wozlol/arduinoboy-RP2040-USB_MIDI_Host/README.md

# Arduinoboy RP2040 HOST EDITION by woz.lol

## Update the firmware
The latest ready-to-flash firmware is in the [Firmware](Firmware) folder. You do not need to compile anything.
1. Download [Arduinoboy-Host-Edition.uf2](Firmware/Arduinoboy-Host-Edition.uf2) (on GitHub, open the file and click the download button).
2. Short the FIRMWARE pads on the board and plug in USB-C to your computer. (you can unshort the pads a second after you plug it in)
3. A drive appears on your computer named `RPI-RP2`. Drag the `.uf2` file onto it.
4. The board restarts by itself and the lights run in order. The update is done.

The [Firmware README](Firmware/README.txt) says which source commit the file was built from and what has been tested.

Based on the ArduinoBoy Repository for serial MIDI communication to the Nintendo Gameboy.

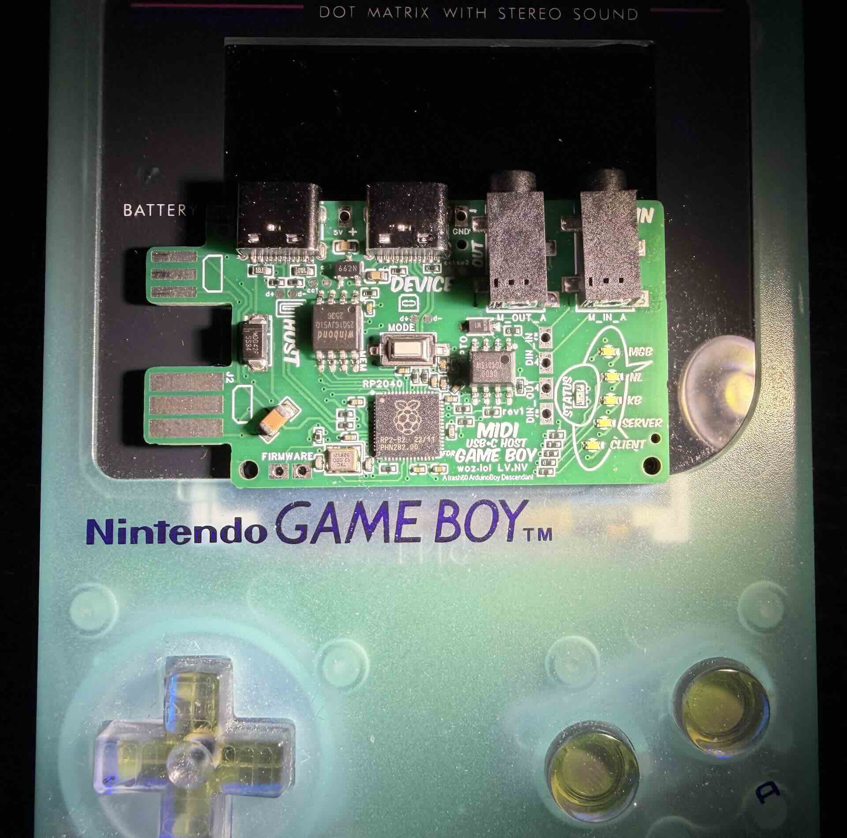
[picture p1: ArduinoBoy_USB_HOST_and_Power_MIDI_Keyboard_from_Gameboy_woz.lol.jpeg]


## About 
Arduinoboy is software for the [Arduino hardware platform](http://arduino.cc) that allows serial communication (MIDI) to the Nintendo Gameboy for music applications such as [LittleSoundDJ](http://littlesounddj.com), [Nanoloop.](http://www.nanoloop.com/), and [mGB](https://github.com/trash80/mGB)

## RP2040 USB MIDI Host Additions
This fork adds RP2040 / Arduino-Pico support focused on USB MIDI host use: a PIO-USB host port for class-compliant USB MIDI keyboards and controllers, plus built-in USB MIDI device support for the Max editor and computer MIDI connections. It has been tested on the Waveshare RP2040 Zero.

The RP2040 built-in USB port enumerates as a USB MIDI device named `Game Boy`. The GPIO14/GPIO15 port works as a USB MIDI host.

## Schematic
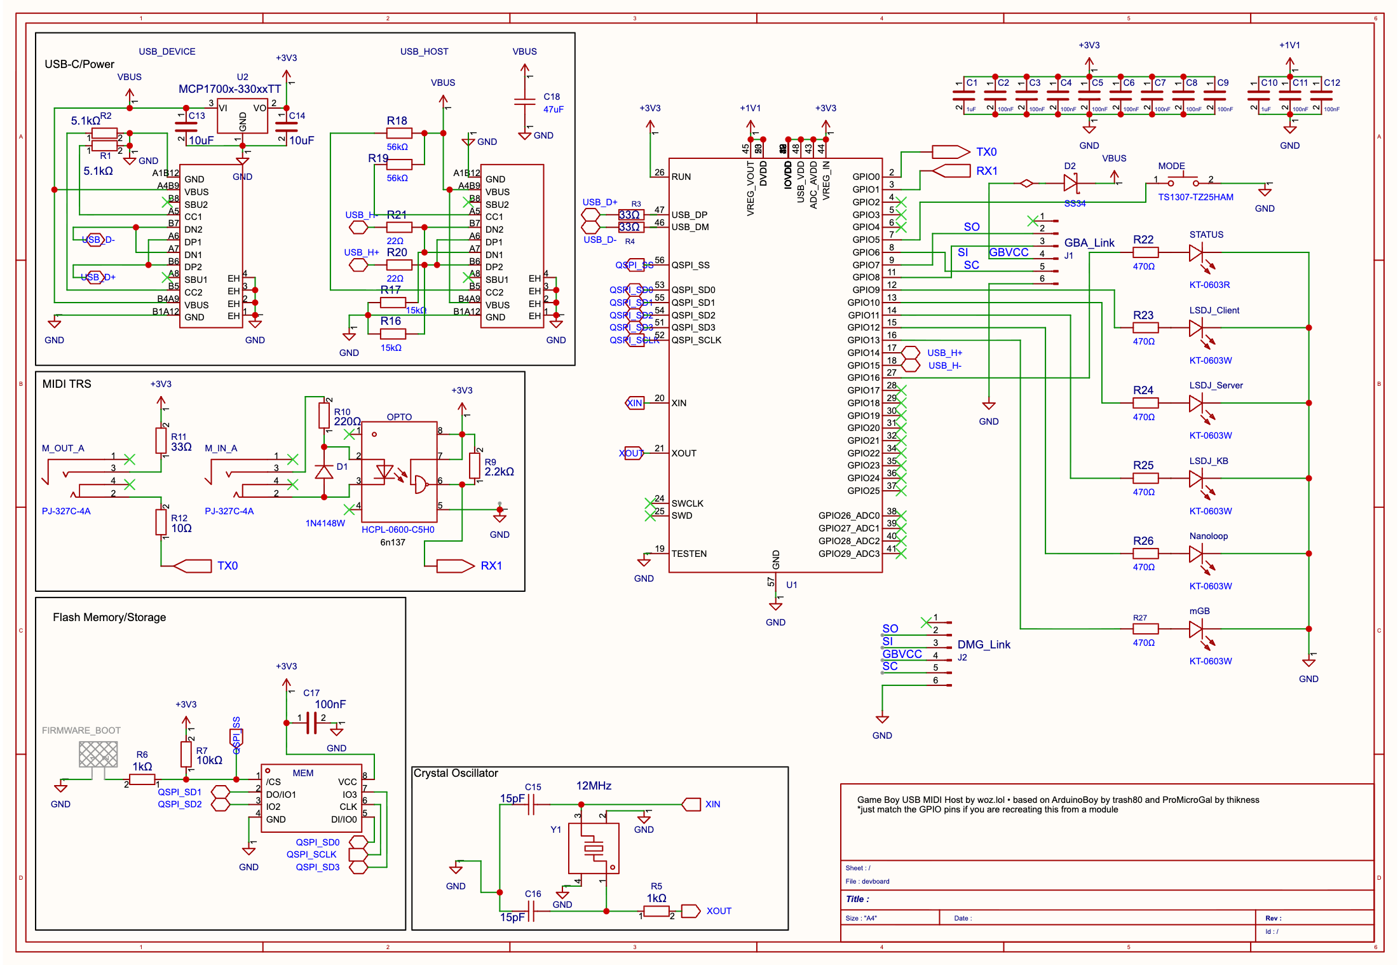
[picture p2: Schematic/SCH_GBHOST_1-GBHOST_2026-07-27.png]
GBHOST schematic


[Download the schematic PDF](Schematic/SCH_GBHOST_2026-07-27.pdf)

<p>
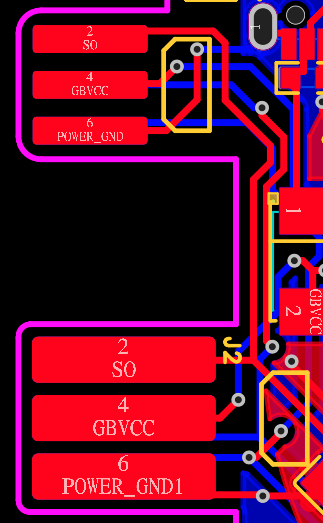
[picture p3: Schematic/game boy jacks front.png]
Game Boy jack front
  
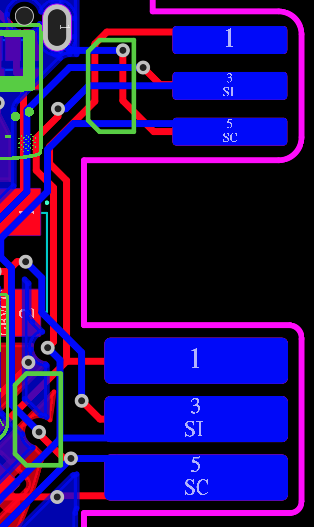
[picture p4: Schematic/game boy jacks back.png]
Game Boy jack back
  
</p>

### RP2040 / Arduino-Pico Pin Settings
* 6 LEDs on GPIO pins 9, 10, 11, 12, 13, 16
* Push button on GPIO pin 5
* Gameboy Clock line on GPIO pin 6
* Gameboy Serial Data input on GPIO pin 7
* Serial Data from gameboy on GPIO pin 8
* USB MIDI host D+ through a 22 ohm resistor to GPIO pin 14
* USB MIDI host D- through a 22 ohm resistor to GPIO pin 15
* USB MIDI host port requires 5V VBUS power, and two 15k resistors: one from D+ to ground, and one from D- to ground.

### RP2040 USB Host Notes
* Set CPU Speed to `240 MHz (Overclock)` for maximum MIDI controller compatibility.
* Use a ground wire to the USB host thicker than 30 AWG.
* Twist D+ and D-, and keep them short.
* Put the 22 ohm resistors near the RP2040.

### Building the firmware
Don't want to build it? Use the ready-made file in the `Firmware` folder and follow the `README.txt` next to it.

To build it yourself in the Arduino IDE:
1. In Boards Manager install "Raspberry Pi Pico/RP2040" by Earle F. Philhower, III, version 5.6.1. In Library Manager install "MIDI Library", version 5.0.2.
2. One-time step: copy the two folders `Adafruit_TinyUSB_Library` and `Pico_PIO_USB` from `Arduinoboy/libraries` into your `Documents/Arduino/libraries` folder, and say yes to replace. Arduino does not look in the repo folder by itself. This swaps in our edited copies for all your projects, and our USB library turns off USB host support for keyboards, storage and serial. If you use those elsewhere, move your original folders somewhere outside `libraries` first.
   On a Mac you can double-click `Install-Libraries-Mac.command` in the repository folder instead. It shows what it will do and asks first, and it moves your own copies to `Documents/Arduino_library_backups` before copying ours in. If macOS refuses to open it, right-click the file and choose Open. On Windows and Linux, copy the folders by hand.
3. Open `Arduinoboy/Arduinoboy.ino`, the file inside the inner `Arduinoboy` folder.
4. Choose Tools > Board: Waveshare RP2040 Zero, CPU Speed: 240 MHz, USB Stack: Adafruit TinyUSB. Press Upload.

If the build stops with "ONE-TIME SETUP NEEDED", step 2 was skipped.

From the command line instead, run this in the repository folder. It uses the repo copies for that one build and changes nothing you have installed: `arduino-cli compile --fqbn rp2040:rp2040:waveshare_rp2040_zero:freq=240,usbstack=tinyusb --library Arduinoboy/libraries/Adafruit_TinyUSB_Library --library Arduinoboy/libraries/Pico_PIO_USB --output-dir Arduinoboy/build Arduinoboy`. The firmware is `Arduinoboy/build/Arduinoboy.ino.uf2`.

## Current Features
* Affordable and easily accessible parts for assembly.
* Accurate MIDI Sync, Start and Stop commands.
* Push Button selector sets the sync/state modes [(7 modes available)](#modes-details)
* [mGB](https://github.com/trash80/mGB)
 Mode: Full MIDI in support across all 4 Gameboy Channels, including a 3-voice polyphony channel which allows you to play your Game Boy like a synthesizer. 
* Midi Out Doubles as a Midi Thru
* "Filtering" data for only sync messages, no dedicated MIDI line required.
* Can be powered by the Game Boy's gamelink port.
* USB upgradeable via Arduino. Short firmware pins for firmware update.
* Midi settings configurable using the new no-install web editor at https://woz.lol/arduinoboy/ or the old Mac/PC editor built in Max.
* Tested and works with DMG (Original), Gameboy Color, and Advance/SP. mGB will not work on an Advance with an Advance cart, an Advance must use a Gameboy cart.

## Modes Details
#### Mode 1 - LSDJ as MIDI Slave Sync
Slave your Game Boy running [LittleSoundDJ](http://littlesounddj.com) to your midi sequencer or Digital audio workstation.  

You can send the arduinoboy midi notes to change sync resolution and start/stop the LSDJ sequencer.  

_LSDJ Slave Mode Midi Note Effects:_

* 48 - `C-2` Sends a Sequencer Start Command
* 49 - `C#2` Sends a Sequencer Stop Command
* 50 - `D-2` Toggles Normal Tempo 
* 51 - `D#2` Toggles 1/2 Tempo
* 52 - `E-2` Toggles 1/4 Tempo
* 53 - `F-2` Toggles 1/8 Tempo

Higher note values than these map LSDJ song position row offset on a Song Start.

In LSDJ the `sync` mode should be set to `MIDI` (`Slave` in older LSDJ versions)
 
#### Mode 2 LSDJ as MIDI Master Sync. 

Send Midi sync with LSDJ as a midi clock master, LSDJ also sends a Midi Note on message that corresponds to the song row number on play.

In LSDJ the `sync` mode should be set to `LSDJ` (`Master` in older LSDJ versions)

#### Mode 3 LSDJ PC Keyboard mode.
This mode emulates the [PC Keyboard Mode](http://littlesounddj.wikia.com/wiki/PC_Keyboard_Interface) built into LSDJ, allowing you to control the following aspects of LSDJ: 

Features:

* The first octave controls M-U-T-E, 
* Cursor control (LSDJ Live mode only), 
* Table selection
* Table cue.

_PC Keyboard mode midi note map_

* 36 - `C-1` Mute Pu1 Off/On
* 37 - `C#1` Mute Pu2 Off/On
* 38 - `D-1` Mute Wav Off/On
* 39 - `D#1` Mute Noi Off/On
* 40 - `E-1` Livemode Cue Sequence
* 41 - `F-1` Livemode Cursor Up
* 42 - `F#1` Livemode Cursor Down
* 43 - `G-1` Livemode Cursor Left
* 44 - `G#1` Live mode Cursor Right
* 45 - `A-1` Table Up
* 46 - `A#1` Table Down
* 47 - `B-1` Cue Table
* 48+ - Notes from this note up will accept midi in from an external keyboard or sequencer and allow you to play the notes`C-2 to C-8`.  
* Midi Program Change messages will select from instrument table
* Default Midi channel is 16. You can set this in the top of the main source file in the archive, or via the [Max Pat editor](#max).

In LSDJ the `sync` mode should be set to `KEYBD` (`Keyboard` in older LSDJ versions)

#### Mode 4 MIDI to Nanoloop sync
Sync [Nanoloop.](http://www.nanoloop.com/) to external midi clock signals sent to the midi in.

In Nanoloop, the sync mode should be set to `slave`.

#### Mode 5 Full MIDI with mGB
[mGB](https://github.com/trash80/mGB) is a Gameboy cartridge program (You need a Flash Cart and Transfer hardware) That enables the Gameboy to act as a MIDI supported sound module that allows full control of the Game Boy sound hardware.

It works with the old DMG Gameboy as well as GBC/GBA. Game Boy Advance must use a non-Advance Game Boy cart.

On the RP2040 build, mGB mode also provides a three-way MIDI thru. MIDI received
from the serial MIDI port, built-in USB MIDI device port, or USB MIDI host port
is sent to the Game Boy as before and mirrored to all three MIDI outputs. This
allows the Arduinoboy to work as a USB MIDI adapter while it is in mGB mode.

#### Mode 6 LSDJ MIDIMAP 
Lsdj will sync to incoming MIDI sync, and incoming MIDI notes are mapped to LSDJ's song row #. The currently selected row's MIDI note is displayed on the top right of the LSDJ screen, and incoming MIDI notes will also display the relative song row number in the same location.

In LSDJ the `sync` mode should be set to `MI.MAP`. 

*This requires a special version of LSDJ, which can be found in your account on the [LSDJ website](http://littlesounddj.com/lsd/latest/full_version/).*

#### Mode 7 LSDJ MIDIOUT
Each of the 4 gameboy channels send MIDI data on 4 midi channels by the use of effects commands:

* `Nxx` - Sends a MIDI Note - Absolute to the value placed in the effect. N00 sends note off, `N01`-`N6F` send midi notes 1 to 112.
* `Qxx` - Sends a [MIDI Note](http://www.electronics.dit.ie/staff/tscarff/Music_technology/midi/midi_note_numbers_for_octaves.htm) relative to the current channel's pitch. The effect value is a offset. so `Q0C` in `PU1` would send a note 1 octave higher than what `PU1` is currently playing. This is useful as a table command to track midi notes as normal notes in the sequencer.
* `Xxx` - Sends a MIDI CC - By default in Arduinoboy the high nibble selects a CC#, and the low nibble sends a value `0-F` to `0-127`. This can be changed to allow just 1 midi CC with a range of `00`-`6F`, or 7 CCs with scaled or unscaled values.
* `Yxx` - Sends a program/patch/preset change.

By default each channel of LSDJ is mapped to midi channels 1-4. For example note commands from PU1 will be sent to midi channel 1. 

In LSDJ the `sync` mode should be set to `Midiout`. 

*This requires a special version of LSDJ, which can be found in your account on the [LSDJ website](http://littlesounddj.com/lsd/latest/full_version/).*

## New Web Editor
Editor gui
[The No-Install Web Editor for Arduinoboy](https://woz.lol/arduinoboy/)
Allows you to edit the various global midi settings of your arduinoboy without editing or flashing code, over midi, from your Chrome browser.

## Max Editor
[The Arduinoboy Editor for Max](https://github.com/trash80/Arduinoboy/tree/master/Editor) for PC/OSX machines is a gui editor that allows you to edit the various global midi settings of your arduinoboy without editing or flashing code, over midi. It used to required the now deprecated Max Runtime, but you can also run it using a demo of [Cycling '74's Max application](https://cycling74.com/downloads/)

### Maxpat Settings
* `Midi In/Out`
Connect your arduinoboy to these ports on your system. Once it has connected, all the lights on your arduinoboy should flash in order, and the editor will show a green `Connected`.
* `Mode` 
Setting this will tell your arduinoboy what mode to boot into automatically. This is handy if you built your own arduinoboy and decided you wanted to skimp out on LEDs and a button.
* `LSDJ Slave Mode settings` - The midi channel LSDJ slave mode will receive its commands on.
* `LSDJ Master Mode settings` - The midi channel LSDJ Master mode will send its midi notes mapped to row number on.
* `Keyboard Mode settings` - What channel LSDJ will look for its keyboard mode midi commands. No idea what compatibility mode does.
* `mGB midi settings` - Map each incoming midi channel to a specific Gameboy channel in mGB.
* `LSDJ Livesync/Livemap settings` - The midi channel Livesync/Livemap will listen to incoming midi commands from.
* `LSDJ Midiout settings` - Here you can set the following:
	* `Note midi channel` -  The channel each LSDJ channel will send it's midi note commands on.
	* `CC midi channel` -  The channel each LSDJ channel will send it's Continuous Controller commands on.
	* `CC 0` - The initial CC each channel will send. The type of data it will send is based on the next setting.
	* `CC Mode` - Game Boys have limitations! You can either have arduinoboy send one CC with many values, or 7 with limited 8bit values. By default in Arduinoboy the high nibble selects a CC#, and the low nibble sends a value [0-F] to [0-127]. This can be changed to allow just 1 midi CC with a range of 00-6F, or 7 CCs with scaled or unscaled values.
	* `CC Scaling ` - Set wether the 7 CCs are scaled or unscaled.

* [Build Photos](http://flickr.com/photos/trash80/2316803175/in/set-72157604068871573/)
* [Old version (Pre 1.1.0)](http://trash80.net/junkfood/arduinoboy/arduinoboy-schem-v.0.9.8-r1.png)

### Video Demos

  * [Keyboard Mode Test](http://youtube.com/watch?v=TnLUuvc78XY)
  * [Sync Demos](http://youtube.com/watch?v=iVmhy-Lo7BI)
  * [Arduino inside of Gameboy DMG](http://youtube.com/watch?v=VwrMuOA0VnY)
  * [mGB Example & Arduinoboy build into a DMG](http://vimeo.com/1853931)
  * [PDF explores mGB with a MIDI guitar](http://www.youtube.com/watch?v=HAU9MzZ2qeE)

## Thanks To
  * [Arduino](http://arduino.cc)
  * [Nitro2k01](http://blog.gg8.se/wordpress/) for ASM help with mGB 
  * [GWEM](http://www.preromanbritain.com/gwem/lsdj_midi/g33k.html) g33k page
  * [Midines](http://wayfar.net) Thanks for the help x|k!
  * [firestARTer](http://www.firestarter-music.de) help with keyboard & Midi handling information. 
  * [Gijs Gieskes](http://gieskes.nl) Found source code that gave insight into Nanoloop sync
  * [Little Sound DJ](http://littlesounddj.com)
  * [http://devrs.com/gb](http://devrs.com/gb) Madcatz PC link port for gb serial specs
  * [http://chipmusic.org](http://chipmusic.org) For all things Chipmusic.
