wozlol/arduinoboy-RP2040-USB_MIDI_Host/Schematic/SCH_GBHOST_2026-07-27.pdf

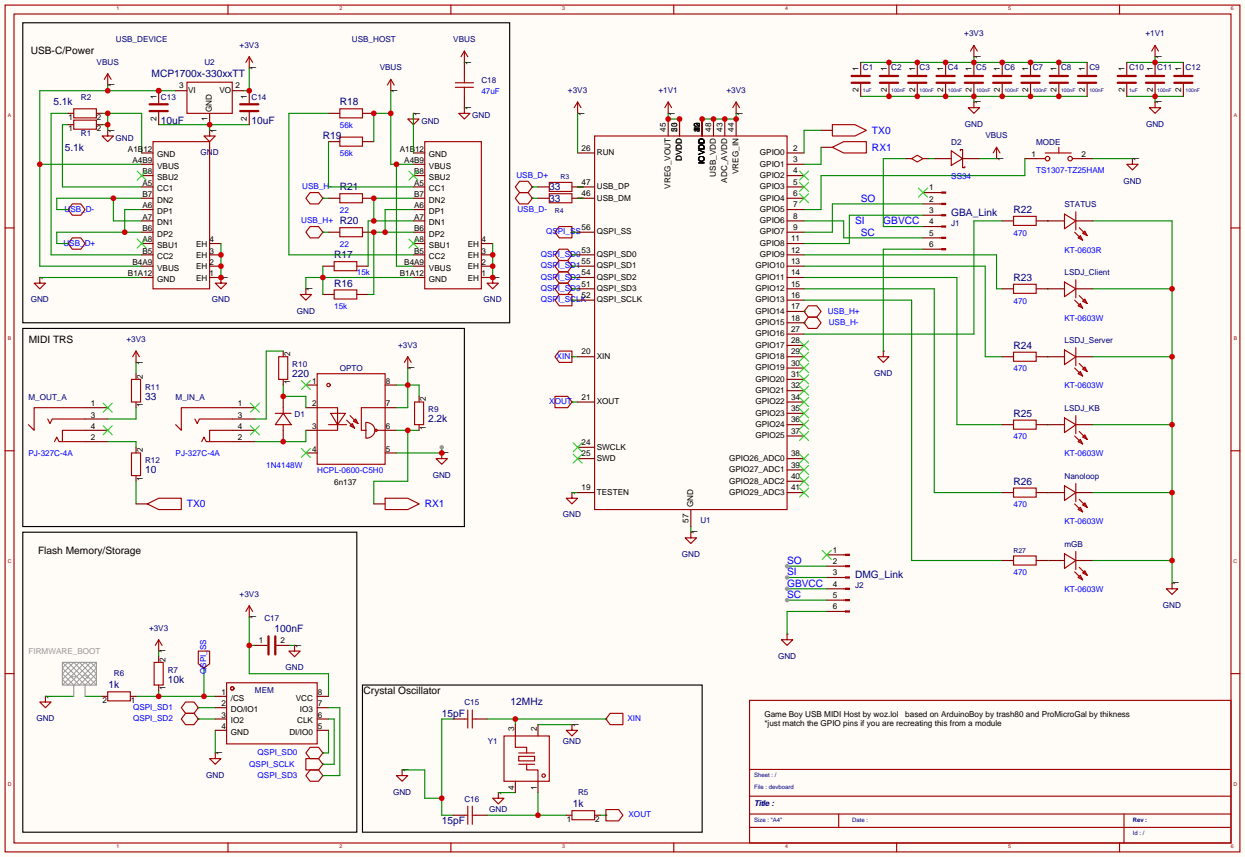
[picture p5: page 1]

Game Boy USB MIDI Host by woz.lol based on ArduinoBoy by trash80 and ProMicroGal by thikness
*just match the GPIO pins if you are recreating this from a module
