wozlol/arduinoboy-RP2040-USB_MIDI_Host/(commit log)

2026-06-29 Add GBHOST schematic assets
2026-06-29 Update GBHOST schematic image
2026-09-09 Harden RP2040 dual-core reliability: watchdog + USB host fixes
    Mode-button freeze (froze cycling through modes, needed repower):
    - Add a real hardware watchdog with phase/mode breadcrumbs
    (Watchdog_Diagnostics.ino) so any hang auto-recovers instead of
    requiring a repower, and reports where it happened on the next boot.
    - Route every EEPROM.commit() through commitMemoryToFlash(), which
    confirms core1 is actually alive before risking the SDK's unbounded
    idleOtherCore() wait.
    USB host MIDI randomly stops receiving on the host port (DIN and the
    USB device port keep working - isolated to core1's PIO-USB host path):
    - USBHost.task() defaults to an indefinite blocking wait; call
    USBHost.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
    [Arduinoboy.ino, Led_Functions.ino, Memory_Functions.ino, Mode.ino, Mode_LSDJ_Keyboard.ino, Mode_LSDJ_Map.ino, Mode_LSDJ_MasterSync.ino, Mode_LSDJ_Midiout.ino]
2026-09-13 Exempt watchdog from idle/programmer USB host stalls, fix sysex send
    Core1-liveness enforcement now only applies when a USB host MIDI
    device is actually mounted, and never while Programmer Mode is
    talking to a host - neither case is worth a full chip reset.
    Also switches usbMidiSendSysEx() to tud_midi_stream_write() instead
    of per-packet writePacket() calls, and wires usbMidiUpdate() into the
    five modes that weren't polling for incoming USB sysex, so Programmer
    Mode can be entered from any mode over USB, not just Keyboard/mGB.
    Claude-Session: https://claude.ai/code/session_01PUcpQP7ZGMsxBHxyxDap5x
    [Mode_LSDJ_Map.ino, Mode_LSDJ_MasterSync.ino, Mode_LSDJ_Midiout.ino, Mode_LSDJ_SlaveSync.ino, Mode_Nanoloop.ino, UsbMidi.ino, Watchdog_Diagnostics.ino]
2026-09-13 Add Arduinoboy Web Editor: browser-based Programmer Mode client
    Speaks the real Arduinoboy Programmer Mode sysex protocol over Web
    MIDI, so it works with any Arduinoboy variant/firmware rather than
    being tied to this fork. Panel layout mirrors the original Max/MSP
    Arduinoboy Editor field-for-field. Design system matches Foxwizard
    Patchling (woz.lol) for continuity, with Arduinoboy's green accent in
    place of Foxwizard's blue.
    Auto-detects and connects to a MIDI port named "Game Boy" on load,
    with manual port selection and disconnect still available.
    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
2026-09-13 Add Host Edition CTA banner, OG/Twitter tags, mobile button labels
    Banner links to the Host Edition hardware product page with an
    inline product photo. Also adds OpenGraph/Twitter card metadata
    matching Foxwizard Patchling's setup, shortens two toolbar button
    labels on mobile, and adds a Nintendo non-affiliation disclaimer to
    the footer.
    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
2026-09-20 Update README: web editor section, mGB Advance cart note
    Documents the new no-install web editor alongside the Max editor,
    and notes mGB/Advance cart compatibility and the firmware update
    pin-short procedure.
2026-09-24 Add concise user instructions manual
    Covers connecting, mode selection (including how 6 LEDs indicate 7
    modes), per-mode note/command maps, settings editors, and firmware
    flashing via the FIRMWARE pads. Also ignores the local Arduino build
    cache directory.
2026-10-07 Stop MGB USB thru echoing back out the same USB port
    USB device MIDI in now goes to DIN and USB host only, and USB host MIDI in
    goes to DIN and USB device only. DIN thru to DIN out is unchanged.
2026-11-07 Add RP2040 USB input and output to modes 1, 2, 4, 6 and 7, and keep our USB library in the repo
    Modes 1, 4 and 6 now read USB clock, transport and notes, the same as the DIN path
    and the Leonardo build. Modes 2 and 7 (and Map mode forwarding) now send over USB.
    All USB output goes to both the USB-C port and the host port.
    The USB host fixes need our edited copy of the Adafruit TinyUSB Library
    (tuh_midi_rx_rearm and three config and timing changes). That copy now lives in
    Arduinoboy/libraries, and sketch.yaml makes arduino-cli use it, so a build from the
    repo matches ours. The sketch stops with a clear error if the stock library is used.
    Not tested on hardware yet.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
2026-11-07 Remove sketch.yaml, Arduino IDE 2.3.4 cannot open a sketch with it
    The IDE's bundled arduino-cli (1.1.1) cannot read 'dir:' library entries in a
    sketch profile and refuses to open the sketch. Build with --library flags or by
    copying the two library folders into Documents/Arduino/libraries instead.
2026-11-08 Allow for repeated key presses in LSDj keyboard mode
    In Arduinoboy mode 3, aka LSDj keyboard mode, currently there's a bug where
    when pressing the same key twice, pressing it doesn't propagate.
    This fix sends PS/2 key releases for MIDI Note Off and before new notes so we do
    actually propagate.
2026-11-13 Keep the current mode's light on, flashes dip it off briefly
    After the 3 blinks on a mode change the mode light(s) now stay on. Anything that flashes a light that is already on dips it off and back on. Mode 5 keeps the status light and lights 1 and 2 on, mode 6 keeps all six on. Also stops sequencerStop writing past the end of the light list in modes 5 and 6. Suggested by Ties Stuij.
2026-11-13 Docs: show the case light for each mode and note the older LSDJ sync names
